lorenalam/TFG/Documentation/SPECS_TFG_PCB_LORENALAM.docx

TRABAJO DE FIN DE GRADO

“ Desarrollo de una PCB Gateway para la gestión de señales en un prototipo ‘Formula Student’ ”

1.DISEÑO PCB

1.1 Medidas que queremos tomar:

-ACELERADOR -analógica

APPS_1

APPS_2

Tasa muestreo – 10 ms (100Hz)

ELPM 75 POP- linear potentiometer- YA COMPRADO

https://www.digikey.es/es/products/detail/variohm/ELPM-75-POP/22286964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

-POTENCIÓMETROS SUSPENSIÓN -analógica

SUSP_FL

SUSP_FR

Tasa muestreo – 10ms/5ms (100Hz-200Hz)

ELPM 75 POP- linear potentiometer -YA COMPRADO

https://www.digikey.es/es/products/detail/variohm/ELPM-75-POP/22286964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

-SENSOR DE PRESIÓN FRENOS- analógica

EPT1400 Pressure Sensor- YA COMPRADO

https://www.variohm.com/products/pressure-sensors/pressure-sensors/ept1400

-SENSOR TEMPERATURA DE DISCO DE FRENO-analógica/digital(SPI)

TEMPS_BRK

Tasa muestreo- (4Hz)

MÓDULO MAX6675

-Tiempo de conversión del módulo ~ 220-250ms

https://www.analog.com/media/en/technical-documentation/data-sheets/max6675.pdf

+TERMOPAR

https://it.farnell.com/pico-technology/se001/type-k-thermocouple-probe-exposed/dp/2842094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|pcrid||&gad_source=1&gad_campaignid=18436055022&gbraid=0AAAAAD8yeHlS3ae2XJ_zIs-uri2sHP3N5&gclid=CjwKCAiAw9vIBhBBEiwAraSATnFp6UBgSgxSIfs22Lk9t7jn8zENQ2MidookhQyCFX7BkOckKrozjxoC0bMQAvD_BwE

-SENSOR TEMPERATURA RUEDAS TESTING x2- digital (I2C)

TEMP_TYRE_1

TEMP_TYRE_2

Tasa muestreo – a partir de 100 ms (10 Hz)

MLX90614

-Tasa de refresco sensor~ 10Hz

https://cdn-reichelt.de/documents/datenblatt/A300/SEN-IR-TEMP_DATASHEET_2022-07-15.pdf

-SENSOR PRESIÓN CARGA AERODINÁMICA- analógica/digital (I2C/SPI)

(pendiente de confirmar por presupuesto)

1.2 Opciones de Microcontroladores:

-Características imprescindibles:

1.CANH FD (Flexible Data-Rate) –> -velocidad del bus hasta 8Mbits/s

-64 bytes por trama

2.Lectura de 5 medidas analóg (al menos 5 canales ADC multiplexados)

3.Comunicación I2C

4.Comunicación SPI

5. Procesamiento de datos a frecuencias medias (10-200Hz)

FAMILIAS DE STM32

STM32F-> NO OK- no soporta CAN FD

STM32G-> OK (gama más nueva)

STM32H->OK (gama más potente)

Resumen de las familias (https://www.google.com/url?psig=AOvVaw0HygEP8Ei9MHWAovS-F1P9&cd=vfe&opi=89978449)

Posibles candidatos:

-STM32H733ZGTx:

Es el actualmente usado en la MCU (Main Control Unit) del prototipo:

Cuenta con estas características:

- Cortex-M7 @ 550 MHz

- 1 MB Flash + 564 KB RAM

- ADCs 16 bits (~3.6 MSps)

- 2× CAN FD

- 6× SPI, 6× I²C, 8× UART

- Ethernet, USB, SDMMC, TFT/LCD, DMA2D

Esta MUY sobredimensionado para las funciones que queremos llevar a cabo en nuestra placa.

-STM32H5xxxx SERIES:

Características generales:

- CPU: ARM Cortex-M33
- Frecuencia CPU típica: ~250 MHz
- Flash: 256 KB – 2 MB
- RAM: 136 KB – 640 KB según modelo
- ADC rápido (14 bits)
- CAN FD
- I²C, SPI, USART

-STM32H503: gama básica (Low-Cost H5)-> NO OK, no integra CAN

-STM32H533 / H535 :gama media (Mainstream H5)-> un poco flojo en cuanto a RAM y Flash

-STM32H563x — High Integration gama industrial-> Sobredimensionado

-STM32H523 / H533 / H563 : gama media-alta (High Integration)-> OK

STM32H523xxx:

- Flash: 512 KB – 2 MB
- RAM: 320–640 KB
- 1 o 2 CAN FD (según el modelo exacto)
- Múltiples SPI (3–6) e I²C (2–4)
- ADC potente (suficientes canales)

-posible: STM32H523CET6

https://static6.arrow.com/aropdfconversion/778a60b664bf8f25dd257b3928806fe0144b5d5/stm32h523ce.pdf

2.ESTADO DE LA TÉCNICA

Denificiones y especificaciones de la 1era version del protocolo CAN:

Specification, C. A. N. (1991). Bosch. Robert Bosch GmbH, Postfach, 50, 15. (https://old.autonerdz.com/yabbfiles/Attachments/can2spec.pdf)

https://www.csselectronics.com/pages/can-bus-simple-intro-tutorial

Denificiones y especificaciones del protocolo CANFD:

Hartwich, F. (2012, March). CAN with flexible data-rate. In Proc. iCC (pp. 1-9). Citeseer. (http://s3.eu-central-1.amazonaws.com/cancia-de/documents/proceedings/2012_hartwich.pdf)

Uso del protocolo y bus CAN para automoción con núcleos RaspberryPi:

Salunkhe, A. A., Kamble, P. P., & Jadhav, R. (2016, May). Design and implementation of CAN bus protocol for monitoring vehicle parameters. In 2016 IEEE international conference on recent trends in electronics, information & communication technology (RTEICT) (pp. 301-304). IEEE (https://ieeexplore.ieee.org/stamp/stamp.jsp?tp=&arnumber=7807831)

IMPLEMENTACIÓN/PRUEBAS EN NUCLEO STM32

NUCLEO-H533RE

PROS:

-Pertenece a la misma familia STM32H5 que el micro final (firmware)

- Incluye FDCAN → permite probar comunicación CAN FD real antes del diseño PCB. - Tiene ADC, SPI, I²C eaccesibles → para validar todos los sensores.

- Trae ST-LINK integrado → programación y depuración inmediatas sin hardware extra

CONTRAS:

- Usa un encapsulado LQFP64: pinout NO compatible con el STM32H523CET6 de la PCB final.

-Tiene más pines y periféricos

-Hay que adaptar el mapeo de pines al pasar al micro definitivo (LQFP48).

-El layout de señales críticas (CAN, ADC, sensores) no representa la PCB real.

-PEDIDO A STMicroelectronics

Otras opcs:

NUCLEO-H503-> ideal pero NO soporta CANFD

STM32CUBE IDE GETTING STARTED:

Intro to núcleo Boards:

Introduction To STM32 & Nucleo Boards - YouTube (https://www.youtube.com/watch?v=mSMsrP31QqA)

Tutorial de STM32: Consejos y trucos para principiantes de STM32CubeIDE

https://www.youtube.com/watch?v=QOHMskuDc78

Getting started w/ NUCLEO-H5:

https://www.youtube.com/watch?v=R6g0OqE_wSo

APUNTES/CONSIDERACIONES

ARCHIVO ioc:

Aquí configuras:

- Los pines (pinout)
- Los periféricos (CAN, ADC, UART, timers…)
- Los relojes (Clock Configuration)
- El middleware ( USB, etc.)

Y el ide ya solo te configura los drivers con los regristors, configs etc pertinentes NO hace falta hacerlo a mano!

- Te genera el código HAL solo

NOTA:

Que es HAL? Hardware Abstraction Layer (Es como una “capa” que simplifica el acceso al hardware.)

Biblioteca oficial de STMicroelectronics, escrita en C, que te permite usar los periféricos del micro (CAN, ADC, UART, timers, GPIO…) con funciones sencillas, sin tener que programar los registros internos del microcontrolador uno a uno.

Nos proporciona un montón de funciones listas para trabajar con:

LAS MÁS TIPICAS:

GPIO (entradas/salidas, LEDs, interrupciones)

Escritura / lectura:

HAL_GPIO_WritePin(GPIOx, GPIO_PIN_y, GPIO_PIN_SET);

HAL_GPIO_WritePin(GPIOx, GPIO_PIN_y, GPIO_PIN_RESET);

HAL_GPIO_TogglePin(GPIOx, GPIO_PIN_y);

HAL_GPIO_ReadPin(GPIOx, GPIO_PIN_y);

ADC (lectura de sensores analógicos)

HAL_ADC_Start(&hadcX);

HAL_ADC_PollForConversion(&hadcX, 10);

value = HAL_ADC_GetValue(&hadcX);

HAL_ADC_Stop(&hadcX);

FDCAN

Iniciar CAN:

HAL_FDCAN_Start(&hfdcan1);

Configurar filtros:

HAL_FDCAN_ConfigFilter(&hfdcan1, &filter);

Enviar mensajes:

HAL_FDCAN_AddMessageToTxFifoQ(&hfdcan1, &TxHeader, TxData);

Activar interrupciones:

HAL_FDCAN_ActivateNotification(&hfdcan1, FDCAN_IT_RX_FIFO0_NEW_MESSAGE, 0);

Recibir mensajes (en callback):

HAL_FDCAN_GetRxMessage(&hfdcan1, FDCAN_RX_FIFO0, &RxHeader, RxData);

CÓMO CONFIGURAR DE MANERA BÁSICA CANFD EN STM32CUBEIDE:

FRAME CAN FD:

1. ID (identificador)

- Igual que en CAN clásico
- Normalmente 11 bits (standard ID)/ También puede ser de 29 bits (extended)

2. DLC (Data Length Code)

- Indica cuántos bytes de datos lleva

3. Datos (payload)

- 0 a 64 bytes, frente a 8 bytes en CAN clásico

4. CRC

- Cyclic Redundancy check (para los errores)

5. Flags específicos de CAN-FD

Los dos más importantes:

- FDF → indica que es un frame CAN-FD
- BRS (Bit Rate Switch) → indica si los datos se envían a mayor velocidad

6. Otros bits y campos

- Ej: Bits de estado

CON EL IDE SOLO TOCAMOS:

-ID
-DLC
-Data[] (hasta 64 bytes)
-FDFormat indica si es can normal o fd
- BitRateSwitch indica si el frame entero va a la misma velocidad o si la parte de datos va mas rápido que la cabecera

El resto (CRC, flags internos, secuencia del frame) lo hace el periférico automáticamente.

ANEXO-SUCIO

-CONFIGURACIÓN DEL BUS CAN EN EL MICRO

-AUTOMOTIVE IC BOARDS STM32 investigar en la pagina web de STM

-STM32cubeID -> investigar el IDE

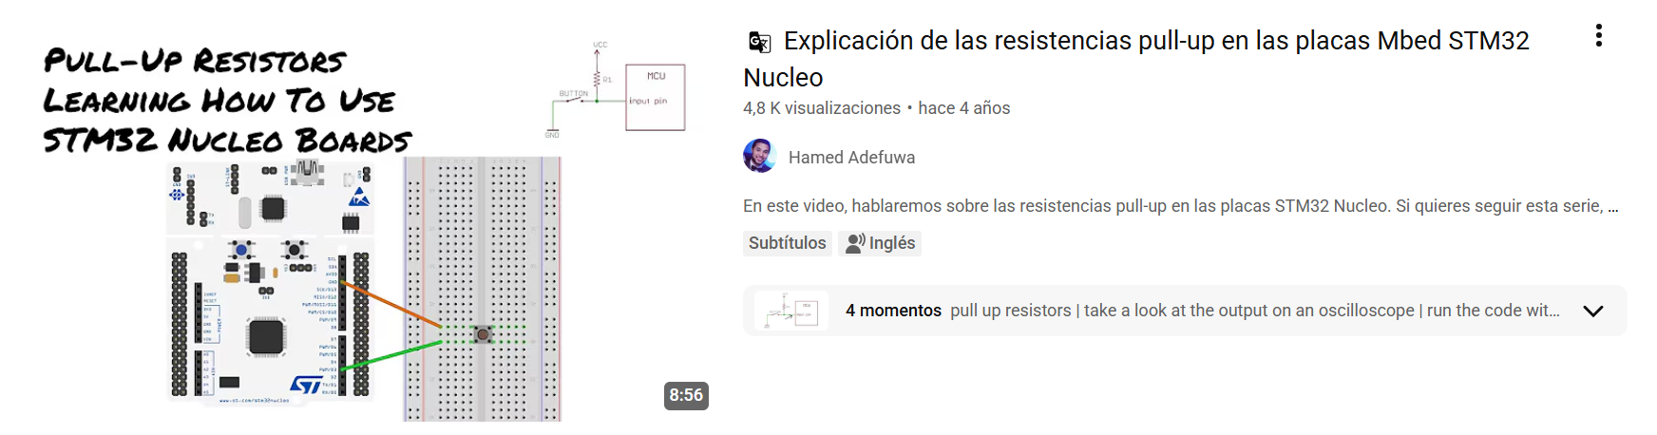
[picture p1: figure]
