lorenalam/TFG/Hardware/PCB_TFG_v1.3/PCB_TFG_v1.3.kicad_pcb

## KiCad design Hardware/PCB_TFG_v1.3/PCB_TFG_v1.3.kicad_pcb (2026-05-29)

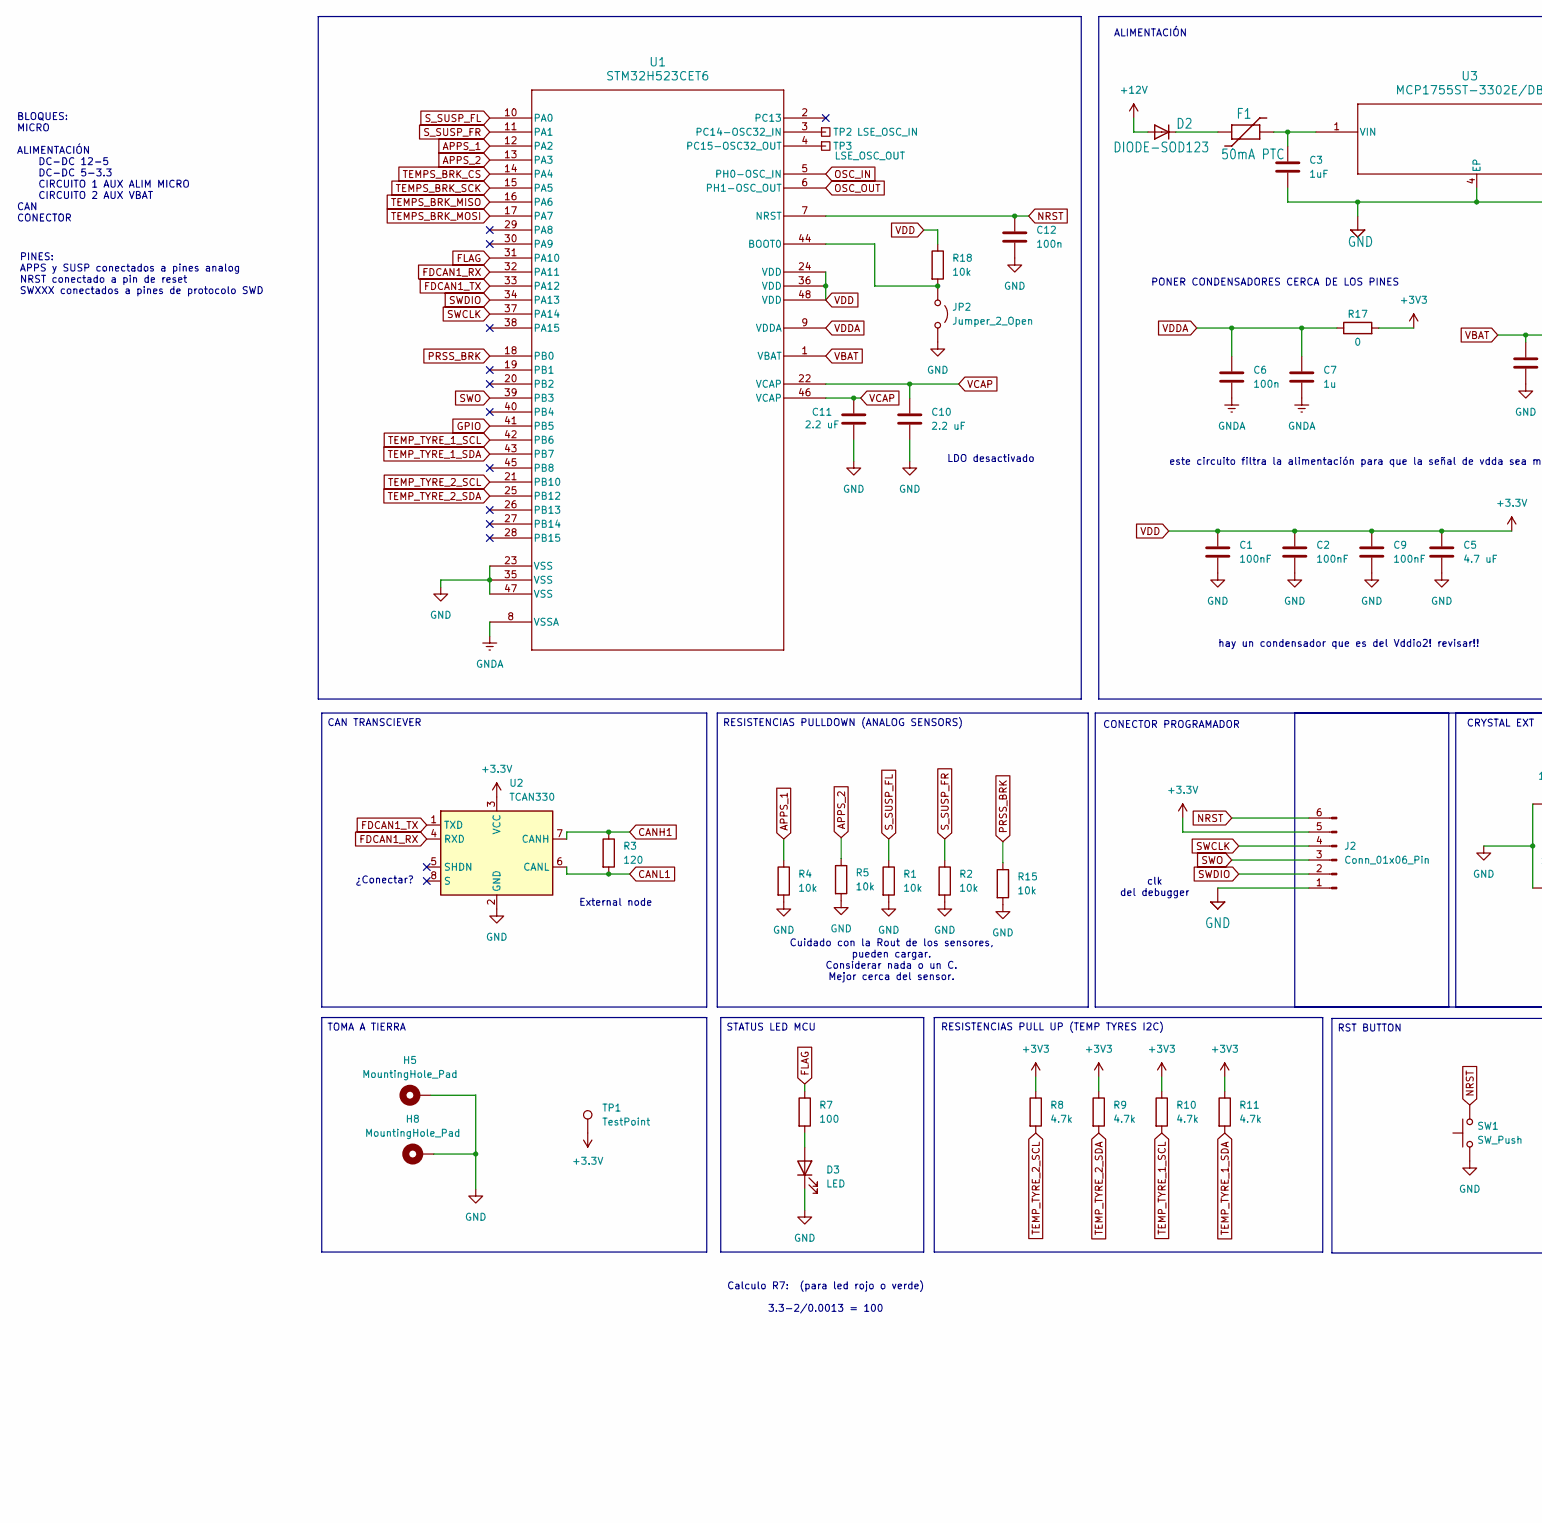
[picture p2: schematic PCB_TFG_v1.3.kicad_sch, part in row 1, column 1]

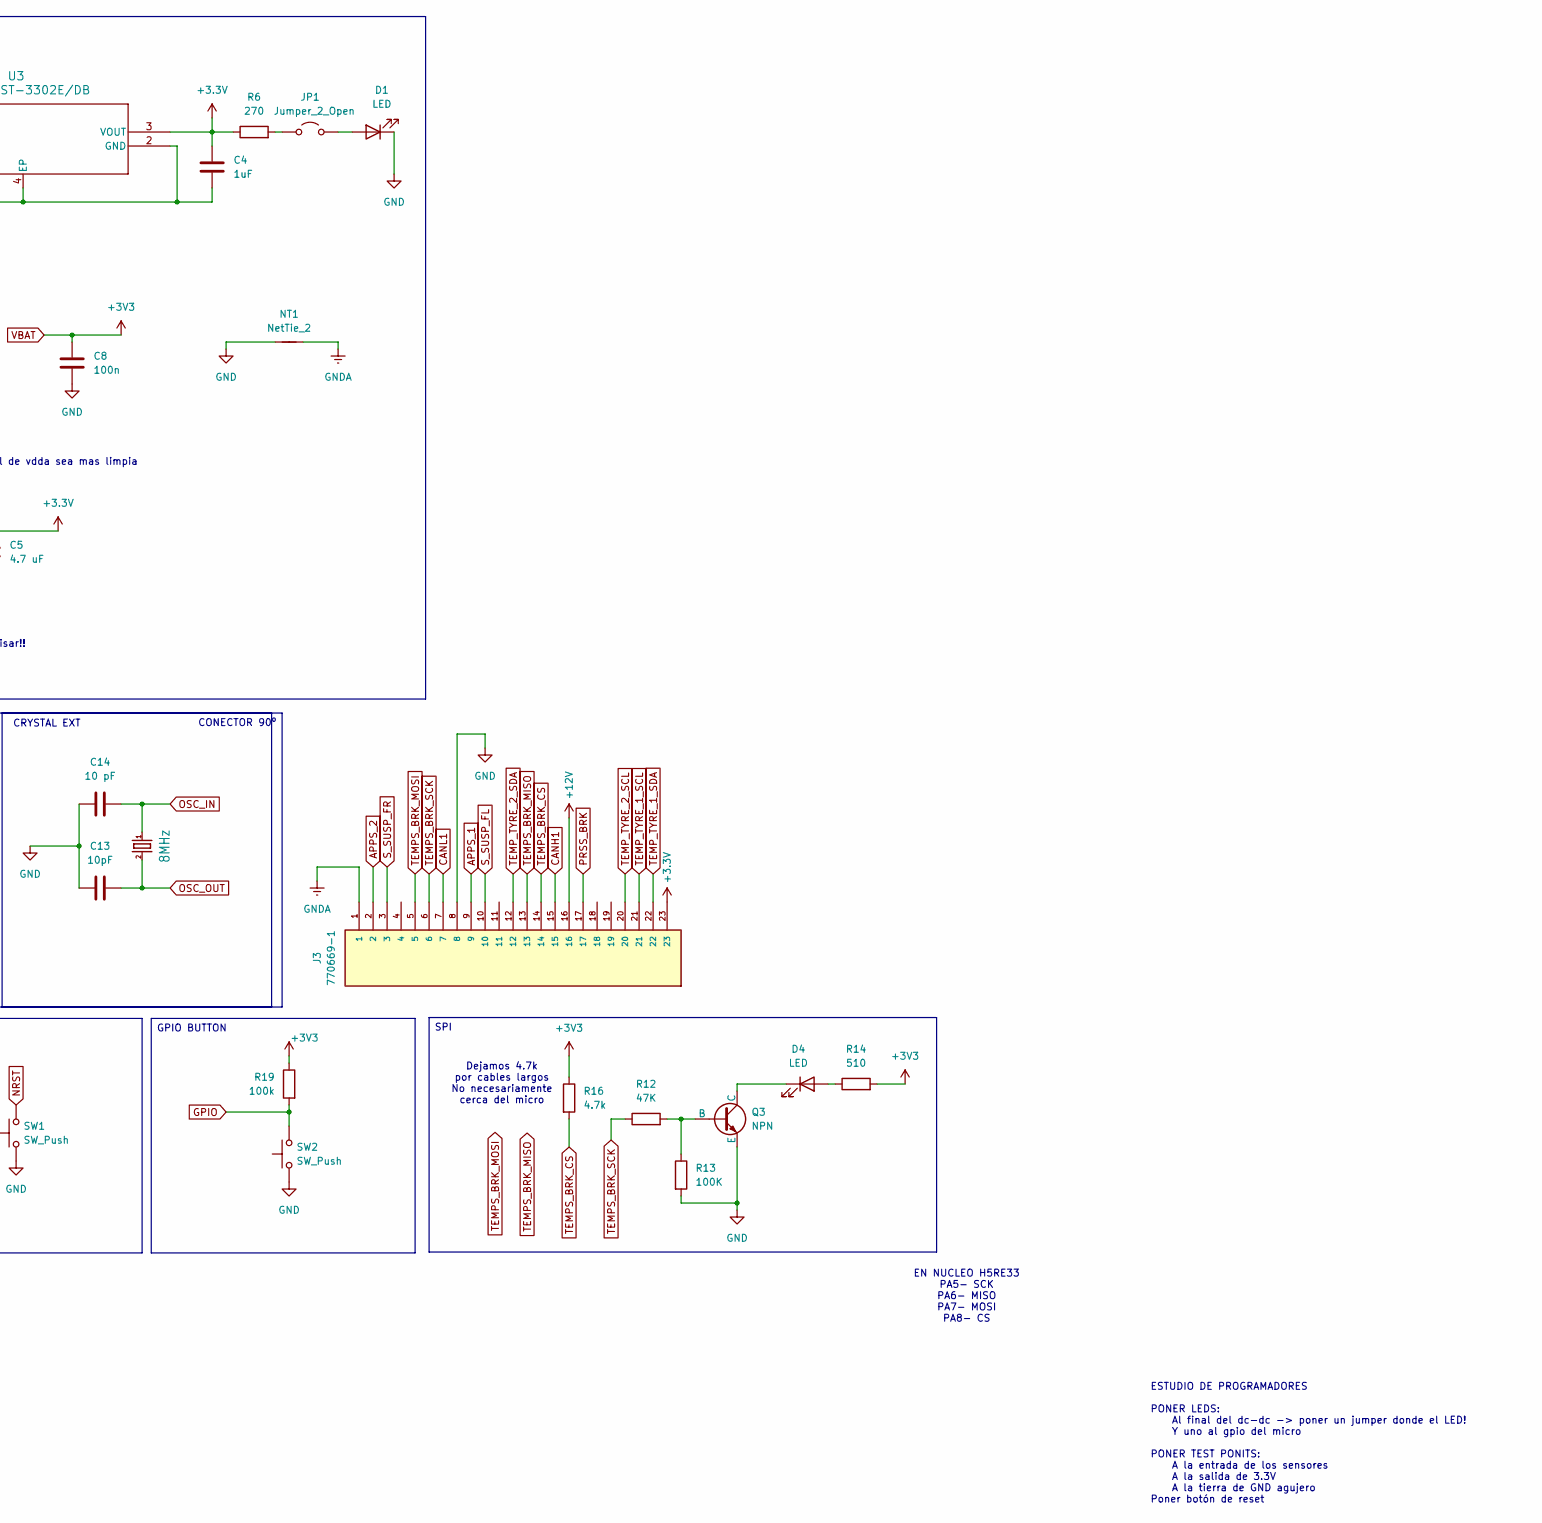
[picture p3: schematic PCB_TFG_v1.3.kicad_sch, part in row 1, column 2]

Parts:
C1, C2, C9: 100nF; C_0805_2012Metric_Pad1.18x1.45mm_HandSolder
C3, C4: 1uF; C_0805_2012Metric_Pad1.18x1.45mm_HandSolder
C5: 4.7 uF; C_0805_2012Metric_Pad1.18x1.45mm_HandSolder
C6, C8, C12: 100n; C_0805_2012Metric_Pad1.18x1.45mm_HandSolder
C7: 1u; C_0805_2012Metric_Pad1.18x1.45mm_HandSolder
C10, C11: 2.2 uF; C_0805_2012Metric_Pad1.18x1.45mm_HandSolder
C13: 10pF; C_0805_2012Metric_Pad1.18x1.45mm_HandSolder
C14: 10 pF; C_0805_2012Metric_Pad1.18x1.45mm_HandSolder
D1, D3, D4: LED; LED_0805_2012Metric_Pad1.15x1.40mm_HandSolder
D2: DIODE-SOD123; SOD123
F1: 50mA PTC; 1206
H5, H8: MountingHole_Pad; MountingHole_3.2mm_M3_ISO14580_Pad_TopBottom
J2: Conn_01x06_Pin; PinHeader_2x03_P2.54mm_Vertical
J3: 770669-1; TE_770669-1; PARTREV K11
JP1: Jumper_2_Open; SolderJumper-2_P1.3mm_Open_RoundedPad1.0x1.5mm
JP2: Jumper_2_Open; PinHeader_1x02_P2.54mm_Vertical
NT1: NetTie_2; NetTie-2_SMD_Pad0.5mm
Q1: 8MHz; CTS406
Q3: NPN; TSOT-23
R1, R2, R4, R5, R15, R18: 10k; R_0805_2012Metric_Pad1.20x1.40mm_HandSolder
R3: 120; R_0805_2012Metric_Pad1.20x1.40mm_HandSolder
R6: 270; R_0805_2012Metric_Pad1.20x1.40mm_HandSolder
R7: 100; R_0805_2012Metric_Pad1.20x1.40mm_HandSolder
R8, R9, R10, R11, R16: 4.7k; R_0805_2012Metric_Pad1.20x1.40mm_HandSolder
R12: 47K; R_0805_2012Metric_Pad1.20x1.40mm_HandSolder
R13: 100K; R_0805_2012Metric_Pad1.20x1.40mm_HandSolder
R14: 510; R_0805_2012Metric_Pad1.20x1.40mm_HandSolder
R17: 0; R_0805_2012Metric_Pad1.20x1.40mm_HandSolder
R19: 100k; R_0805_2012Metric_Pad1.20x1.40mm_HandSolder
SW1, SW2: SW_Push; SW_SPST_B3U-1000P-B
TP1: TestPoint; Pin_D1.0mm_L10.0mm
TP2: LSE_OSC_IN; TestPoint_Pad_1.0x1.0mm
TP3: LSE_OSC_OUT; TestPoint_Pad_1.0x1.0mm
U1: STM32H523CET6; LQFP48_STM
U2: TCAN330; SOIC-8_3.9x4.9mm_P1.27mm
U3: MCP1755ST-3302E/DB; SOT-223_3MC_MCH

Connections:
+12V: D2.A, J3.16
APPS_1: J3.9, R4.1, U1.12 (PA2)
APPS_2: J3.2, R5.1, U1.13 (PA3)
CANH1: J3.15, R3.1, U2.7 (CANH)
CANL1: J3.7, R3.2, U2.6 (CANL)
FDCAN1_RX: U1.32 (PA11), U2.4 (RXD)
FDCAN1_TX: U1.33 (PA12), U2.1 (TXD)
FLAG: R7.1, U1.31 (PA10)
GND: C1.2, C2.2, C3.2, C4.2, C5.2, C8.1, C9.2, C10.2, C11.2, C12.1, C13.1, C14.1, D1.1 (K), D3.1 (K), H5.1 (1_1), H8.1 (1_1), J2.1, J3.8, JP2.2 (B), NT1.1, Q3.3 (E), R1.2, R2.2, R4.2, R5.2, R13.2, R15.2, SW1.1, SW2.1, U1.23 (VSS), U1.35 (VSS), U1.47 (VSS), U2.2 (GND), U3.2 (GND), U3.4 (EP)
GNDA: C6.1, C7.1, J3.1, NT1.2, U1.8 (VSSA)
GPIO: R19.2, SW2.2, U1.41 (PB5)
NRST: C12.2, J2.6, SW1.2, U1.7 (NRST)
unnamed: D1.2 (A), JP1.2 (B)
unnamed: D2.C, F1.P$1
unnamed: D3.2 (A), R7.2
unnamed: D4.2 (A), R14.1
unnamed: D4.1 (K), Q3.1 (C)
unnamed: JP1.1 (A), R6.2
unnamed: JP2.1 (A), R18.2, U1.44 (BOOT0)
unnamed: Q3.2 (B), R12.2, R13.1
unnamed: TP2.1 (1_1), U1.3 (PC14-OSC32_IN)
unnamed: TP3.1 (1_1), U1.4 (PC15-OSC32_OUT)
unnamed: C3.1, F1.P$2, U3.1 (VIN)
OSC_IN: C14.2, Q1.1, U1.5 (PH0-OSC_IN)
OSC_OUT: C13.2, Q1.3 (2), U1.6 (PH1-OSC_OUT)
PRSS_BRK: J3.17, R15.1, U1.18 (PB0)
SWCLK: J2.4, U1.37 (PA14)
SWDIO: J2.2, U1.34 (PA13)
SWO: J2.3, U1.39 (PB3)
S_SUSP_FL: J3.10, R1.1, U1.10 (PA0)
S_SUSP_FR: J3.3, R2.1, U1.11 (PA1)
TEMPS_BRK_CS: J3.14, R16.2, U1.14 (PA4)
TEMPS_BRK_MISO: J3.13, U1.16 (PA6)
TEMPS_BRK_MOSI: J3.5, U1.17 (PA7)
TEMPS_BRK_SCK: J3.6, R12.1, U1.15 (PA5)
TEMP_TYRE_1_SCL: J3.21, R10.2, U1.42 (PB6)
TEMP_TYRE_1_SDA: J3.22, R11.2, U1.43 (PB7)
TEMP_TYRE_2_SCL: J3.20, R8.2, U1.21 (PB10)
TEMP_TYRE_2_SDA: J3.12, R9.2, U1.25 (PB12)
VBAT: C8.2, R8.1, R9.1, R10.1, R11.1, R14.2, R16.1, R17.2, R19.1, U1.1 (VBAT)
VCAP: C10.1, C11.1, U1.22 (VCAP), U1.46 (VCAP)
VDD: C1.1, C2.1, C4.1, C5.1, C9.1, J2.5, J3.23, R6.1, R18.1, TP1.1 (1_1), U1.24 (VDD), U1.36 (VDD), U1.48 (VDD), U2.3 (VCC), U3.3 (VOUT)
VDDA: C6.2, C7.2, R17.1, U1.9 (VDDA)

Notes on the sheet:
PONER CONDENSADORES CERCA DE LOS PINES
ESTUDIO DE PROGRAMADORES PONER LEDS: Al final del dc-dc -> poner un jumper donde el LED! Y uno al gpio del micro PONER TEST PONITS: A la entrada de los sensores A la salida de 3.3V A la tierra de GND agujero Poner botón de reset
EN NUCLEO H5RE33 PA5- SCK PA6- MISO PA7- MOSI PA8- CS
BLOQUES: MICRO ALIMENTACIÓN DC-DC 12-5 DC-DC 5-3.3 CIRCUITO 1 AUX ALIM MICRO CIRCUITO 2 AUX VBAT CAN CONECTOR
CONECTOR PROGRAMADOR
clk del debugger
Cuidado con la Rout de los sensores, pueden cargar. Considerar nada o un C. Mejor cerca del sensor.
RESISTENCIAS PULL UP (TEMP TYRES I2C)
Calculo R7: (para led rojo o verde) 3.3-2/0.0013 = 100
Dejamos 4.7k por cables largos No necesariamente cerca del micro
External node
LDO desactivado
este circuito filtra la alimentación para que la señal de vdda sea mas limpia
¿Conectar?
PINES: APPS y SUSP conectados a pines analog NRST conectado a pin de reset SWXXX conectados a pines de protocolo SWD
hay un condensador que es del Vddio2! revisar!!
ALIMENTACIÓN
CRYSTAL EXT
TOMA A TIERRA
RESISTENCIAS PULLDOWN (ANALOG SENSORS)
GPIO BUTTON
CONECTOR 90º
SPI
CAN TRANSCIEVER
STATUS LED MCU
RST BUTTON

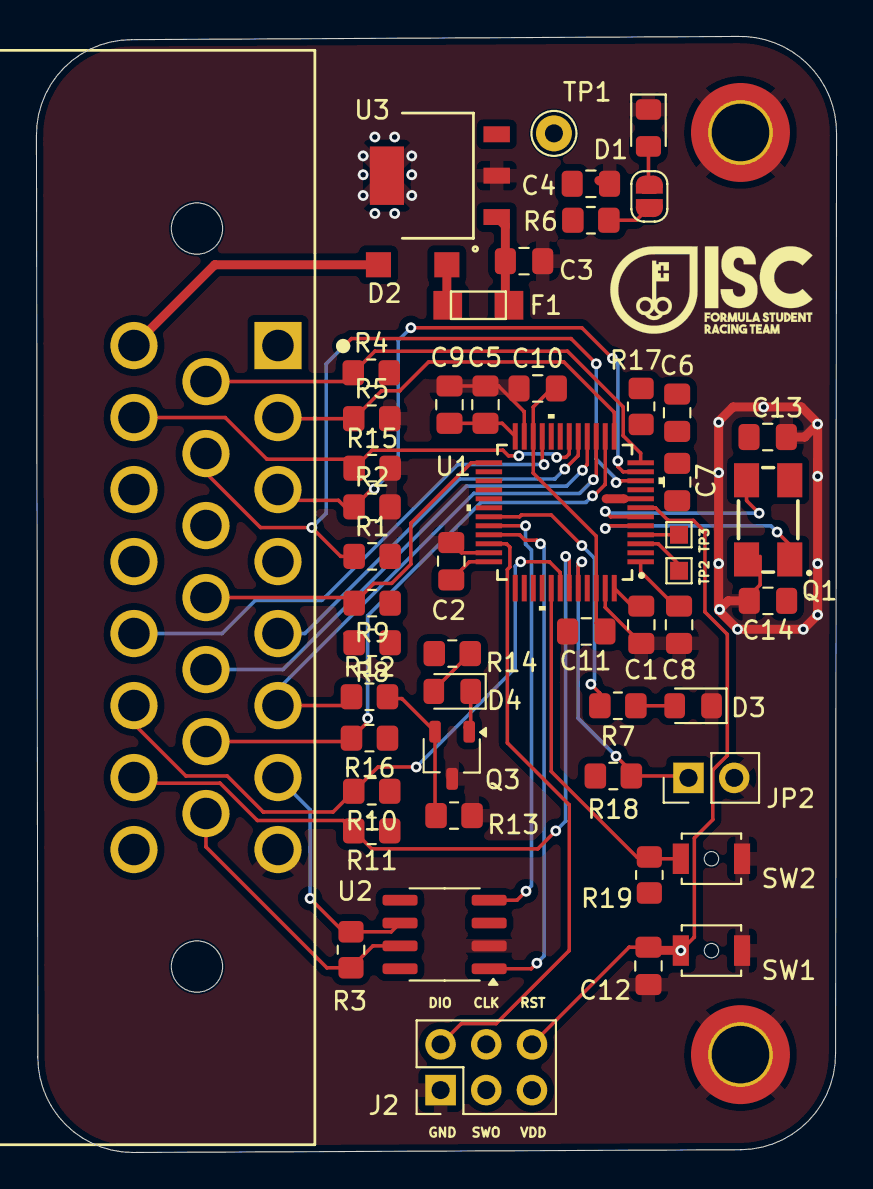
[picture p4: board PCB_TFG_v1.3.kicad_pcb from above]

Board: 4 copper layers, 44.4 x 62.0 mm, 55 parts (0 on the bottom side), 43 nets.
