lorenalam/TFG/Hardware/PCB_TFG_v1.2/PCB_TFG_v1.2.kicad_pcb

## KiCad design Hardware/PCB_TFG_v1.2/PCB_TFG_v1.2.kicad_pcb (2026-05-07, an earlier design)

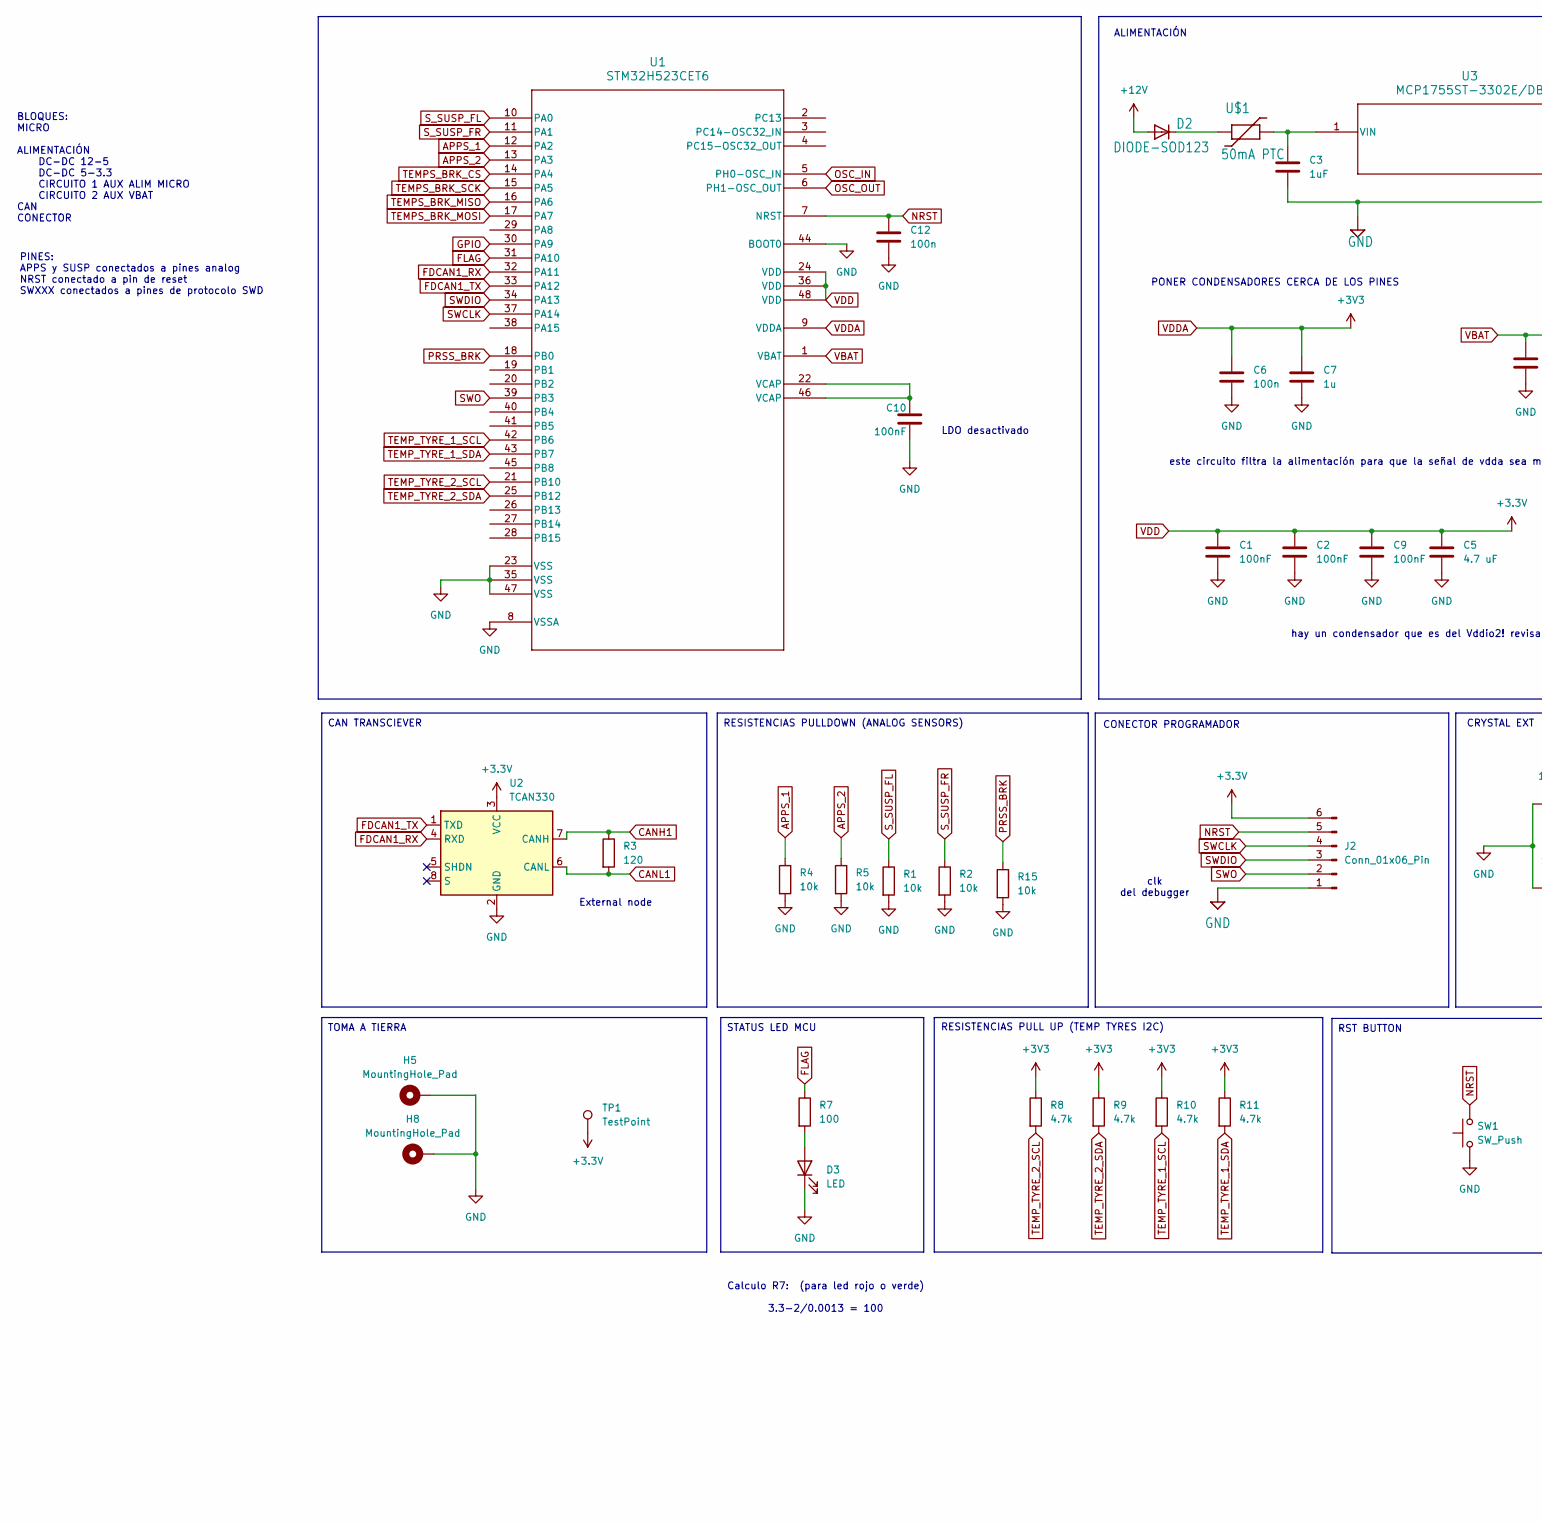
[picture p5: schematic PCB_TFG_v1.2.kicad_sch, part in row 1, column 1]

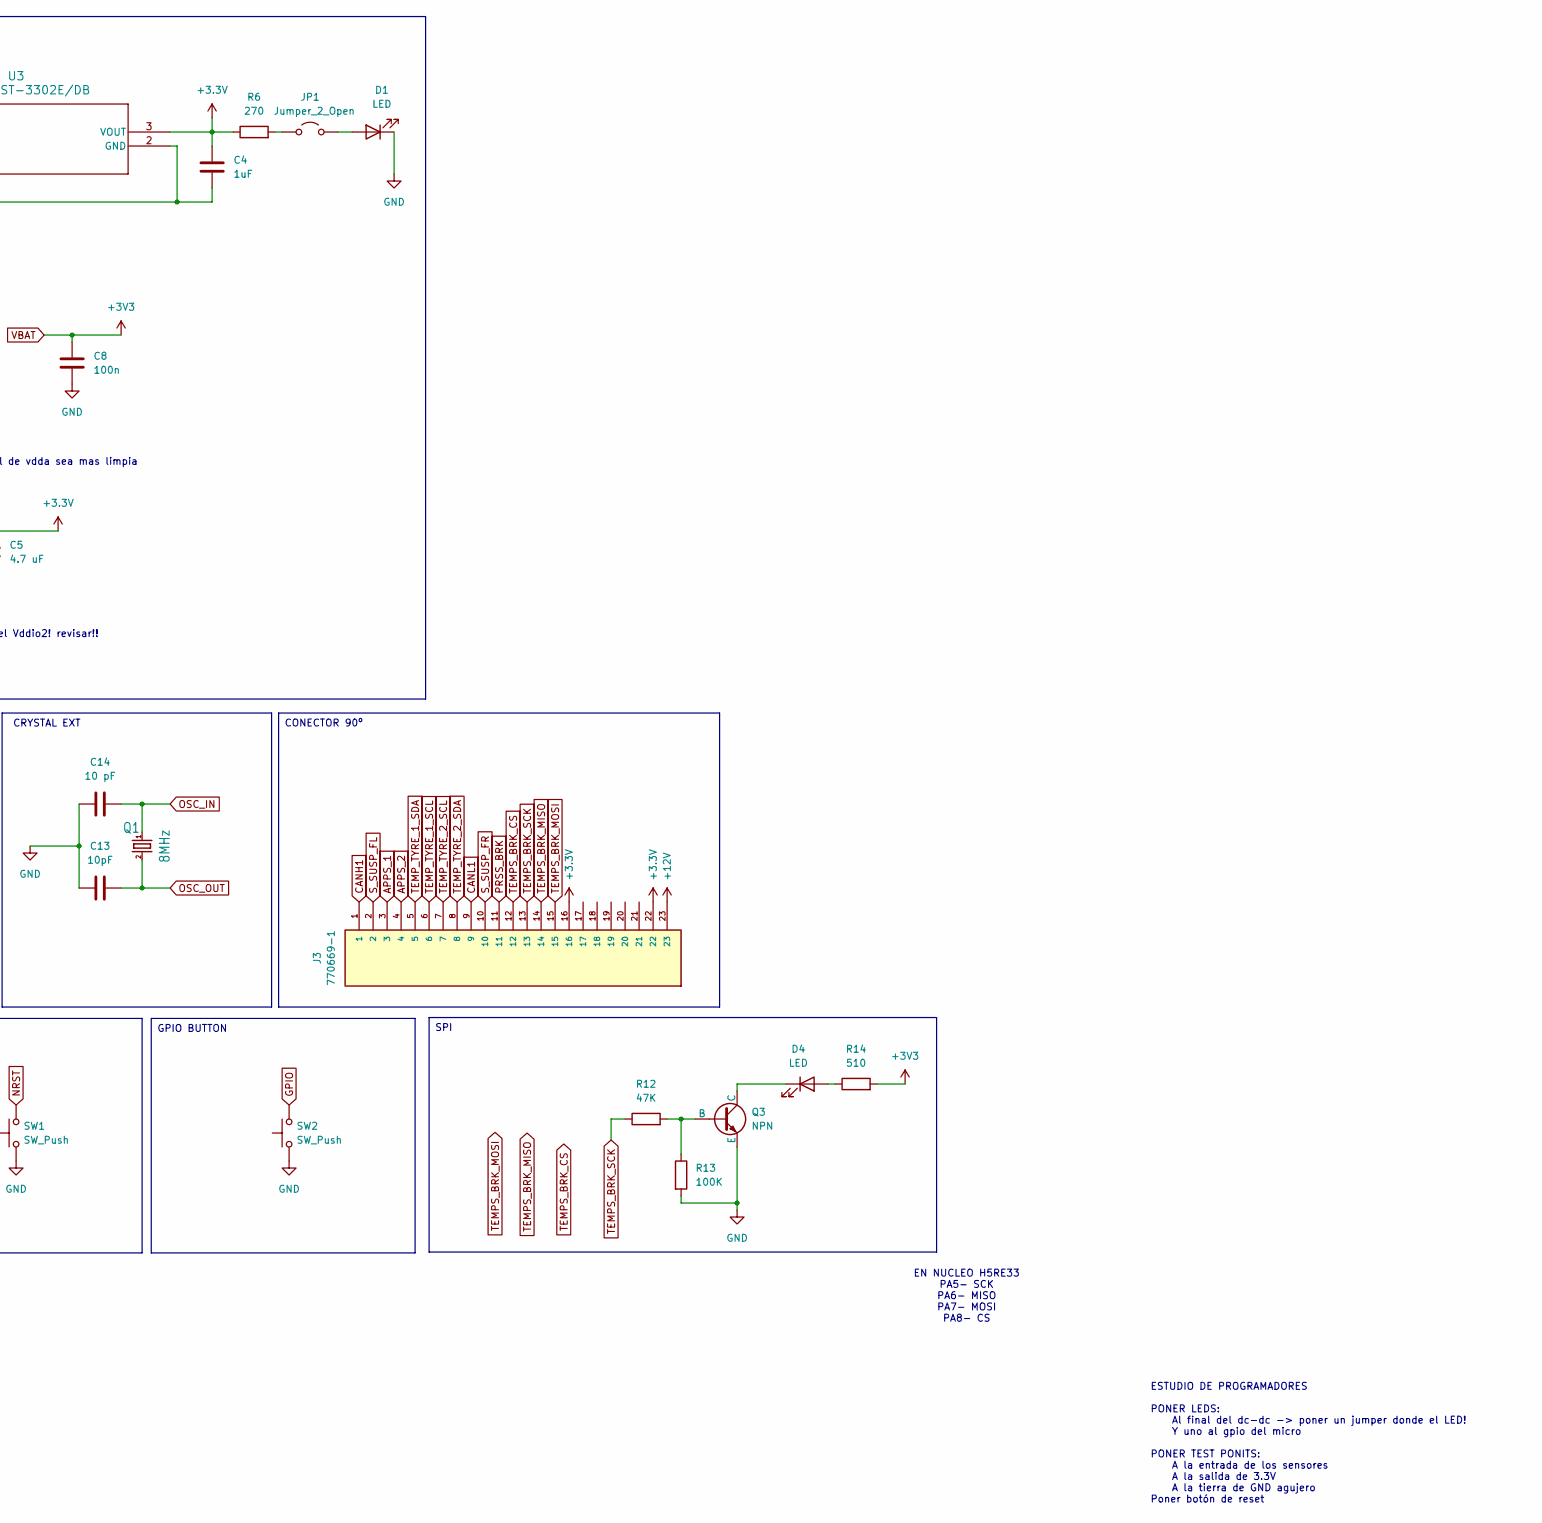
[picture p6: schematic PCB_TFG_v1.2.kicad_sch, part in row 1, column 2]

Parts:
C1, C2, C9, C10: 100nF; C_0805_2012Metric_Pad1.18x1.45mm_HandSolder
C3, C4: 1uF; C_0805_2012Metric_Pad1.18x1.45mm_HandSolder
C5: 4.7 uF; C_0805_2012Metric_Pad1.18x1.45mm_HandSolder
C6, C8: 100n; C_0805_2012Metric_Pad1.18x1.45mm_HandSolder
C7: 1u; C_0805_2012Metric_Pad1.18x1.45mm_HandSolder
C12: 100n; C_0603_1608Metric_Pad1.08x0.95mm_HandSolder
C13: 10pF; C_0805_2012Metric_Pad1.18x1.45mm_HandSolder
C14: 10 pF; C_0805_2012Metric_Pad1.18x1.45mm_HandSolder
D1, D3, D4: LED; LED_0805_2012Metric_Pad1.15x1.40mm_HandSolder
D2: DIODE-SOD123; SOD123
H5, H8: MountingHole_Pad; MountingHole_3.2mm_M3_ISO14580_Pad_TopBottom
J2: Conn_01x06_Pin; PinHeader_2x03_P2.54mm_Vertical
J3: 770669-1; TE_770669-1; PARTREV K11
JP1: Jumper_2_Open; SolderJumper-2_P1.3mm_Open_RoundedPad1.0x1.5mm
Q1: 8MHz; CTS406
Q3: NPN; TSOT-23
R1, R2, R4, R5, R15: 10k; R_0805_2012Metric_Pad1.20x1.40mm_HandSolder
R3: 120; R_0805_2012Metric_Pad1.20x1.40mm_HandSolder
R6: 270; R_0805_2012Metric_Pad1.20x1.40mm_HandSolder
R7: 100; R_0805_2012Metric_Pad1.20x1.40mm_HandSolder
R8, R9, R10, R11: 4.7k; R_0805_2012Metric_Pad1.20x1.40mm_HandSolder
R12: 47K; R_0805_2012Metric_Pad1.20x1.40mm_HandSolder
R13: 100K; R_0805_2012Metric_Pad1.20x1.40mm_HandSolder
R14: 510; R_0805_2012Metric_Pad1.20x1.40mm_HandSolder
SW1, SW2: SW_Push; SW_PUSH_6mm_H4.3mm
TP1: TestPoint; Pin_D1.0mm_L10.0mm
U1: STM32H523CET6; LQFP48_STM
U2: TCAN330; SOIC-8_3.9x4.9mm_P1.27mm
U3: MCP1755ST-3302E/DB; SOT-223_3MC_MCH
U$1: 50mA PTC; 1206

Connections:
+12V: D2.A, J3.23
APPS_1: J3.3, R4.1, U1.12 (PA2)
APPS_2: J3.4, R5.1, U1.13 (PA3)
CANH1: J3.1, R3.1, U2.7 (CANH)
CANL1: J3.9, R3.2, U2.6 (CANL)
FDCAN1_RX: U1.32 (PA11), U2.4 (RXD)
FDCAN1_TX: U1.33 (PA12), U2.1 (TXD)
FLAG: R7.1, U1.31 (PA10)
GND: C1.2, C2.2, C3.2, C4.2, C5.2, C6.1, C7.1, C8.1, C9.2, C10.2, C12.1, C13.1, C14.1, D1.1 (K), D3.1 (K), H5.1, H8.1, J2.1, Q3.3 (E), R1.2, R2.2, R4.2, R5.2, R13.2, R15.2, SW1.1, SW2.1, U1.8 (VSSA), U1.23 (VSS), U1.35 (VSS), U1.44 (BOOT0), U1.47 (VSS), U2.2 (GND), U3.2 (GND)
GPIO: SW2.2, U1.30 (PA9)
NRST: C12.2, J2.5, SW1.2, U1.7 (NRST)
unnamed: C10.1, U1.22 (VCAP), U1.46 (VCAP)
unnamed: D1.2 (A), JP1.2 (B)
unnamed: D2.C, U$1.P$1
unnamed: D3.2 (A), R7.2
unnamed: D4.2 (A), R14.1
unnamed: D4.1 (K), Q3.1 (C)
unnamed: JP1.1 (A), R6.2
unnamed: Q3.2 (B), R12.2, R13.1
unnamed: C3.1, U3.1 (VIN), U$1.P$2
OSC_IN: C14.2, Q1.1, U1.5 (PH0-OSC_IN)
OSC_OUT: C13.2, Q1.3 (2), U1.6 (PH1-OSC_OUT)
PRSS_BRK: J3.11, R15.1, U1.18 (PB0)
SWCLK: J2.4, U1.37 (PA14)
SWDIO: J2.3, U1.34 (PA13)
SWO: J2.2, U1.39 (PB3)
S_SUSP_FL: J3.2, R1.1, U1.10 (PA0)
S_SUSP_FR: J3.10, R2.1, U1.11 (PA1)
TEMPS_BRK_CS: J3.12, U1.14 (PA4)
TEMPS_BRK_MISO: J3.14, U1.16 (PA6)
TEMPS_BRK_MOSI: J3.15, U1.17 (PA7)
TEMPS_BRK_SCK: J3.13, R12.1, U1.15 (PA5)
TEMP_TYRE_1_SCL: J3.6, R10.2, U1.42 (PB6)
TEMP_TYRE_1_SDA: J3.5, R11.2, U1.43 (PB7)
TEMP_TYRE_2_SCL: J3.7, R8.2, U1.21 (PB10)
TEMP_TYRE_2_SDA: J3.8, R9.2, U1.25 (PB12)
VBAT: C6.2, C7.2, C8.2, R8.1, R9.1, R10.1, R11.1, R14.2, U1.1 (VBAT), U1.9 (VDDA)
VDD: C1.1, C2.1, C4.1, C5.1, C9.1, J2.6, J3.16, J3.22, R6.1, TP1.1, U1.24 (VDD), U1.36 (VDD), U1.48 (VDD), U2.3 (VCC), U3.3 (VOUT)

Notes on the sheet:
TOMA A TIERRA
RESISTENCIAS PULLDOWN (ANALOG SENSORS)
GPIO BUTTON
CONECTOR 90º
SPI
CAN TRANSCIEVER
STATUS LED MCU
RST BUTTON
PONER CONDENSADORES CERCA DE LOS PINES
ESTUDIO DE PROGRAMADORES PONER LEDS: Al final del dc-dc -> poner un jumper donde el LED! Y uno al gpio del micro PONER TEST PONITS: A la entrada de los sensores A la salida de 3.3V A la tierra de GND agujero Poner botón de reset
EN NUCLEO H5RE33 PA5- SCK PA6- MISO PA7- MOSI PA8- CS
BLOQUES: MICRO ALIMENTACIÓN DC-DC 12-5 DC-DC 5-3.3 CIRCUITO 1 AUX ALIM MICRO CIRCUITO 2 AUX VBAT CAN CONECTOR
CONECTOR PROGRAMADOR
clk del debugger
RESISTENCIAS PULL UP (TEMP TYRES I2C)
Calculo R7: (para led rojo o verde) 3.3-2/0.0013 = 100
External node
LDO desactivado
este circuito filtra la alimentación para que la señal de vdda sea mas limpia
PINES: APPS y SUSP conectados a pines analog NRST conectado a pin de reset SWXXX conectados a pines de protocolo SWD
hay un condensador que es del Vddio2! revisar!!
ALIMENTACIÓN
CRYSTAL EXT

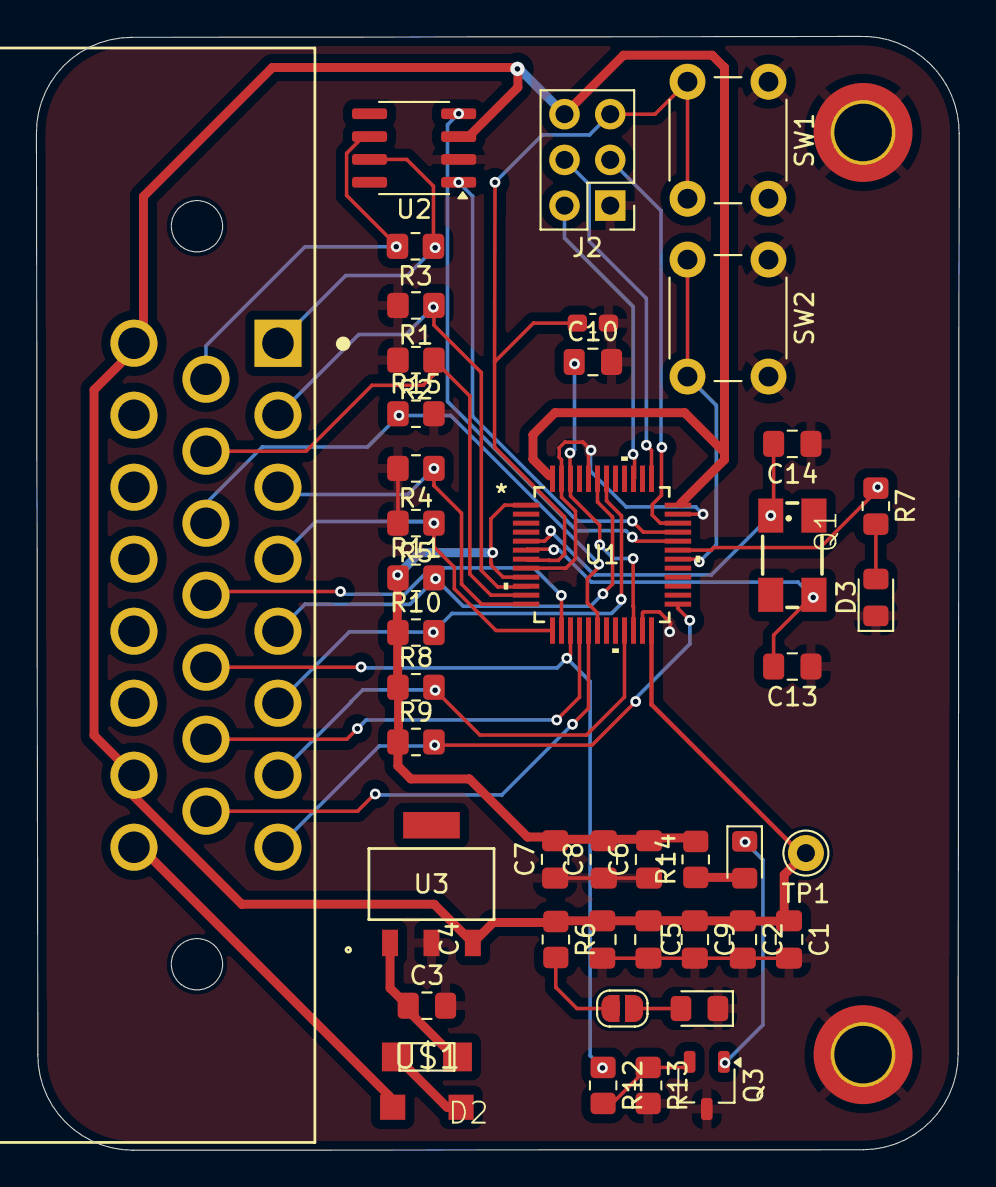
[picture p7: board PCB_TFG_v1.2.kicad_pcb from above]

Board: 2 copper layers, 51.3 x 61.9 mm, 46 parts (0 on the bottom side), 38 nets.
