lorenalam/TFG/Software/NUCLEO_TFG_v2/Core/Src/main.c

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
/* Includes ------------------------------------------------------------------*/
#include "main.h"

/* USER CODE BEGIN PD */

// --- Sensor de presion EPT1400 ---
#define EPT1400_PMAX        100.0f   // bar del modelo
#define EPT1400_VMIN        0.5f     // V a 0 bar (offset del sensor, del datasheet)
#define EPT1400_VSPAN       4.0f     // V de recorrido (4.5 - 0.5, del datasheet)
#define EPT1400_DIVIDER_K   0.6471f  // divisor R1=10k, R2=18.2k -> 4.5V se mapea a 2.91V

// --- Sensor de temperatura de rueda MLX90614 ---
#define MLX90614_ADDR     (0x5A << 1)   // direccion 7-bit desplazada para HAL
#define MLX90614_TOBJ1    0x07          // registro temperatura del objeto

// --- IDs de las tramas CAN ---
#define CAN_ID_APPS     0x100   // acelerador (APPS_1, APPS_2)
#define CAN_ID_SUSP     0x101   // suspension (SUSP_FL, SUSP_FR)
#define CAN_ID_BRAKE    0x102   // presion de freno
#define CAN_ID_TEMPS    0x103   // temperaturas (disco, rueda1, rueda2)

// --- Periodos del scheduler (ms) ---
#define PERIOD_FAST     10      // 100 Hz: APPS, suspension, freno
#define PERIOD_SLOW     250     // 4 Hz: temperaturas

/* USER CODE END PD */


COM_InitTypeDef BspCOMInit;
ADC_HandleTypeDef hadc1;

FDCAN_HandleTypeDef hfdcan1;

I2C_HandleTypeDef hi2c1;
I2C_HandleTypeDef hi2c2;

SPI_HandleTypeDef hspi2;

/* USER CODE BEGIN PV */

//ADC
#define ADC_N_CHANNELS 5
uint16_t adc_val[ADC_N_CHANNELS];
enum { APPS_1 = 0, APPS_2, SUSP_FL, SUSP_FR, BRAKE };

//SPI
float   temp_disco    = 0.0f;   // °C, temperatura disco de freno (MAX6675)
uint8_t max6675_fault = 0;      // 1 = termopar desconectado

//I2C
float temp_tyre1 = 0.0f;   // °C, temperatura rueda 1 (MLX90614 en I2C1)
float temp_tyre2 = 0.0f;   // °C, temperatura rueda 2 (MLX90614 en I2C2)

//CAN
FDCAN_TxHeaderTypeDef TxHeaderApps;
FDCAN_TxHeaderTypeDef TxHeaderSusp;
FDCAN_TxHeaderTypeDef TxHeaderBrake;
FDCAN_TxHeaderTypeDef TxHeaderTemps;

uint32_t t_last_fast = 0;
uint32_t t_last_slow = 0;

/* USER CODE END PV */

void SystemClock_Config(void);
static void MX_GPIO_Init(void);
static void MX_ADC1_Init(void);
static void MX_FDCAN1_Init(void);
static void MX_SPI2_Init(void);
static void MX_I2C1_Init(void);
static void MX_I2C2_Init(void);

/* USER CODE BEGIN PFP */

static void CAN_InitHeader(FDCAN_TxHeaderTypeDef *h, uint32_t id, uint32_t dlc);

/* USER CODE END PFP */

/* USER CODE BEGIN 0 */
static void CAN_InitHeader(FDCAN_TxHeaderTypeDef *h, uint32_t id, uint32_t dlc)
{
    h->Identifier          = id;
    h->IdType              = FDCAN_STANDARD_ID;
    h->TxFrameType         = FDCAN_DATA_FRAME;
    h->DataLength          = dlc;
    h->ErrorStateIndicator = FDCAN_ESI_ACTIVE;
    h->BitRateSwitch       = FDCAN_BRS_ON;
    h->FDFormat            = FDCAN_FD_CAN;
    h->TxEventFifoControl  = FDCAN_NO_TX_EVENTS;
    h->MessageMarker       = 0;
}
/* USER CODE END 0 */

/**
  * @brief  The application entry point.
  * @retval int
  */
int main(void)
{

  /* MCU Configuration--------------------------------------------------------*/

  /* Reset of all peripherals, Initializes the Flash interface and the Systick. */
  HAL_Init();

  /* Configure the system clock */
  SystemClock_Config();

  /* Initialize all configured peripherals */
  MX_GPIO_Init();
  MX_ADC1_Init();
  MX_FDCAN1_Init();
  MX_SPI2_Init();
  MX_I2C1_Init();
  MX_I2C2_Init();
  /* USER CODE BEGIN 2 */

  //ADC CALIBRACIÓN
  if (HAL_ADCEx_Calibration_Start(&hadc1, ADC_SINGLE_ENDED) != HAL_OK)
  {
      Error_Handler();
  }

  // Cabeceras de las 4 tramas
  CAN_InitHeader(&TxHeaderApps,  CAN_ID_APPS,  FDCAN_DLC_BYTES_4);  // 2x uint16
  CAN_InitHeader(&TxHeaderSusp,  CAN_ID_SUSP,  FDCAN_DLC_BYTES_4);  // 2x uint16
  CAN_InitHeader(&TxHeaderBrake, CAN_ID_BRAKE, FDCAN_DLC_BYTES_2);  // 1x uint16
  CAN_InitHeader(&TxHeaderTemps, CAN_ID_TEMPS, FDCAN_DLC_BYTES_8);  // 3x int16 + flags

  /* USER CODE END 2 */

  /* Initialize leds */
  BSP_LED_Init(LED_GREEN);

  /* Initialize USER push-button, will be used to trigger an interrupt each time it's pressed.*/
  BSP_PB_Init(BUTTON_USER, BUTTON_MODE_EXTI);

  /* Initialize COM1 port (115200, 8 bits (7-bit data + 1 stop bit), no parity */
  BspCOMInit.BaudRate   = 115200;
  BspCOMInit.WordLength = COM_WORDLENGTH_8B;
  BspCOMInit.StopBits   = COM_STOPBITS_1;
  BspCOMInit.Parity     = COM_PARITY_NONE;
  BspCOMInit.HwFlowCtl  = COM_HWCONTROL_NONE;
  if (BSP_COM_Init(COM1, &BspCOMInit) != BSP_ERROR_NONE)
  {
    Error_Handler();
  }

  /* Infinite loop */
  /* USER CODE BEGIN WHILE */
  while (1)
  {     uint32_t now = HAL_GetTick();

  // ===== GRUPO RÁPIDO (100 Hz) =====
  if (now - t_last_fast >= PERIOD_FAST)
  {
      t_last_fast = now;

      // --- Lectura ADC (5 canales) ---
      HAL_ADC_Start(&hadc1);
      for (int i = 0; i < ADC_N_CHANNELS; i++)
      {
          if (HAL_ADC_PollForConversion(&hadc1, 10) == HAL_OK)
              adc_val[i] = HAL_ADC_GetValue(&hadc1);
          else
              adc_val[i] = 0xFFFF;
      }
      HAL_ADC_Stop(&hadc1);

      // Presion de freno en bar, escalada x10 -> uint16
      float v_brake_adc = (adc_val[BRAKE] * 3.3f) / 4095.0f;
      float v_brake     = v_brake_adc / EPT1400_DIVIDER_K;
      float p_brake     = (v_brake - EPT1400_VMIN) * EPT1400_PMAX / EPT1400_VSPAN;
      uint16_t brake_x10 = (uint16_t)(p_brake * 10.0f);

      // --- Empaquetado y envio: APPS (raw ADC, big-endian) ---
      uint8_t dApps[4];
      dApps[0] = (uint8_t)(adc_val[APPS_1] >> 8);
      dApps[1] = (uint8_t)(adc_val[APPS_1] & 0xFF);
      dApps[2] = (uint8_t)(adc_val[APPS_2] >> 8);
      dApps[3] = (uint8_t)(adc_val[APPS_2] & 0xFF);
      HAL_FDCAN_AddMessageToTxFifoQ(&hfdcan1, &TxHeaderApps, dApps);

      // --- Suspension (raw ADC) ---
      uint8_t dSusp[4];
      dSusp[0] = (uint8_t)(adc_val[SUSP_FL] >> 8);
      dSusp[1] = (uint8_t)(adc_val[SUSP_FL] & 0xFF);
      dSusp[2] = (uint8_t)(adc_val[SUSP_FR] >> 8);
      dSusp[3] = (uint8_t)(adc_val[SUSP_FR] & 0xFF);
      HAL_FDCAN_AddMessageToTxFifoQ(&hfdcan1, &TxHeaderSusp, dSusp);

      // --- Presion de freno (bar x10) ---
      uint8_t dBrake[2];
      dBrake[0] = (uint8_t)(brake_x10 >> 8);
      dBrake[1] = (uint8_t)(brake_x10 & 0xFF);
      HAL_FDCAN_AddMessageToTxFifoQ(&hfdcan1, &TxHeaderBrake, dBrake);
  }

  // ===== GRUPO LENTO (4 Hz) =====
  if (now - t_last_slow >= PERIOD_SLOW)
  {
      t_last_slow = now;

      // --- Lectura SPI (MAX6675) ---
      uint8_t  spi_rx[2] = {0};
      uint16_t spi_raw   = 0;
      HAL_GPIO_WritePin(SPI2_TEMP_BRK_GPIO_Port, SPI2_TEMP_BRK_Pin, GPIO_PIN_RESET);
      if (HAL_SPI_Receive(&hspi2, spi_rx, 2, 10) == HAL_OK)
      {
          spi_raw = ((uint16_t)spi_rx[0] << 8) | spi_rx[1];
          if (spi_raw & 0x0004)
          {
              max6675_fault = 1;
              temp_disco = -1.0f;
          }
          else
          {
              max6675_fault = 0;
              temp_disco = ((spi_raw >> 3) & 0x0FFF) * 0.25f;
          }
      }
      HAL_GPIO_WritePin(SPI2_TEMP_BRK_GPIO_Port, SPI2_TEMP_BRK_Pin, GPIO_PIN_SET);

      // --- Lectura I2C (2x MLX90614) ---
      uint8_t mlx_buf[2] = {0};
      if (HAL_I2C_Mem_Read(&hi2c1, MLX90614_ADDR, MLX90614_TOBJ1,
                           I2C_MEMADD_SIZE_8BIT, mlx_buf, 2, 10) == HAL_OK)
          temp_tyre1 = (((uint16_t)mlx_buf[1] << 8) | mlx_buf[0]) * 0.02f - 273.15f;

      if (HAL_I2C_Mem_Read(&hi2c2, MLX90614_ADDR, MLX90614_TOBJ1,
                           I2C_MEMADD_SIZE_8BIT, mlx_buf, 2, 10) == HAL_OK)
          temp_tyre2 = (((uint16_t)mlx_buf[1] << 8) | mlx_buf[0]) * 0.02f - 273.15f;

      // --- Empaquetado: temperaturas (int16, °C x10) + flag ---
      int16_t td  = (int16_t)(temp_disco * 10.0f);
      int16_t tt1 = (int16_t)(temp_tyre1 * 10.0f);
      int16_t tt2 = (int16_t)(temp_tyre2 * 10.0f);

      uint8_t dTemps[8];
      dTemps[0] = (uint8_t)(td  >> 8);
      dTemps[1] = (uint8_t)(td  & 0xFF);
      dTemps[2] = (uint8_t)(tt1 >> 8);
      dTemps[3] = (uint8_t)(tt1 & 0xFF);
      dTemps[4] = (uint8_t)(tt2 >> 8);
      dTemps[5] = (uint8_t)(tt2 & 0xFF);
      dTemps[6] = max6675_fault;     // byte de flags
      dTemps[7] = 0;                 // reservado
      HAL_FDCAN_AddMessageToTxFifoQ(&hfdcan1, &TxHeaderTemps, dTemps);

      // --- Debug opcional (descomentar para ver por terminal) ---
      // printf("BRK:%.1f bar | Disco:%.1f Rueda1:%.1f Rueda2:%.1f C (fault=%u)\r\n",
      //        p_brake, temp_disco, temp_tyre1, temp_tyre2, max6675_fault);
  }
      /* USER CODE END WHILE */

    /* USER CODE BEGIN 3 */
  }
  /* USER CODE END 3 */
}

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
