lorenalam/TFG/Software/NUCLEO_TFG_v2/Core/Inc/main.h

#define SPI2_MOSI_TEMP_BRK_Pin GPIO_PIN_1
#define SPI2_MOSI_TEMP_BRK_GPIO_Port GPIOC
#define SPI2_MISO_TEMP_BRK_Pin GPIO_PIN_2
#define SPI2_MISO_TEMP_BRK_GPIO_Port GPIOC
#define APPS_1_Pin GPIO_PIN_0
#define APPS_1_GPIO_Port GPIOA
#define APPS_2_Pin GPIO_PIN_1
#define APPS_2_GPIO_Port GPIOA
#define SUSP_FL_Pin GPIO_PIN_6
#define SUSP_FL_GPIO_Port GPIOA
#define SUSP_FR_Pin GPIO_PIN_4
#define SUSP_FR_GPIO_Port GPIOC
#define PRSS_BRK_Pin GPIO_PIN_1
#define PRSS_BRK_GPIO_Port GPIOB
#define SPI2_SCK_TEMP_BRK_Pin GPIO_PIN_2
#define SPI2_SCK_TEMP_BRK_GPIO_Port GPIOB
#define I2C2_SCL_TEMP_TYRE_2_Pin GPIO_PIN_10
#define I2C2_SCL_TEMP_TYRE_2_GPIO_Port GPIOB
#define I2C2_SDA_TEMP_TYRE_2_Pin GPIO_PIN_12
#define I2C2_SDA_TEMP_TYRE_2_GPIO_Port GPIOB
#define SPI2_TEMP_BRK_Pin GPIO_PIN_8
#define SPI2_TEMP_BRK_GPIO_Port GPIOA
#define SWDIO_Pin GPIO_PIN_13
#define SWDIO_GPIO_Port GPIOA
#define SWCLK_Pin GPIO_PIN_14
#define SWCLK_GPIO_Port GPIOA
#define JTDI_Pin GPIO_PIN_15
#define JTDI_GPIO_Port GPIOA
#define SWO_Pin GPIO_PIN_3
#define SWO_GPIO_Port GPIOB
#define I2C1_SCL_TEMP_TYRE_1_Pin GPIO_PIN_6
#define I2C1_SCL_TEMP_TYRE_1_GPIO_Port GPIOB
#define I2C1_SDA_TEMP_TYRE_1_Pin GPIO_PIN_7
#define I2C1_SDA_TEMP_TYRE_1_GPIO_Port GPIOB
