lorenalam/TFG/(commit log)

2026-01-19 1st upload
    Archivos -prueba canfd -prueba sensores
2026-02-17 v1.2 adc integrado con CANFD
    + prueba aproximada parámetros SPI
2026-04-22 Hardware PCB v1.2
    Versión PCB para posible fabricación
    [PCB_TFG_v1.2.kicad_pcb, PCB_TFG_v1.2.kicad_sch, PCB_TFG_v1.kicad_pcb, PCB_TFG_v1.kicad_sch]
2026-05-07 PCB v1.3
    Cambios:
    Cs de acoplamiento
    Oscilador
    SPI
    Vías alimentación
    Pendiente:
    Vías disipación
    [PCB_TFG_v1.2.kicad_pcb, PCB_TFG_v1.3.kicad_pcb, PCB_TFG_v1.3.kicad_sch]
2026-05-25 AÑADIDO PROYECTO KICAD NUCLEO
    - Se añade el proyecto de KiCAD con el PCB y esquema de la tarjeta núcleo, extraída del proyecto de Altium de los recursos de STM
2026-05-25 CREADA LA CARPETA DE DOCUMENTACIÓN PARA PCB
    - Se añaden los documentos para diseño de PCB de STM
    - Se añaden los documentos para cálculo de Heat Sink
2026-05-25 MODIFICACIONES AL PCB
    - Separación de Áreas Analógica y Digital.
    - Creación de dos planos de GND y Vcc en capas intermedias.
    - Recolocación de los C de desacoplo.
    [PCB_TFG_v1.3.kicad_pcb, PCB_TFG_v1.3.kicad_sch]
2026-05-29 ENRUTADO COMPLETADO
    - Nueva versión del PCB ya enrutado.
    - Modificadas huellas de algunos componentes, principalmente para incluir marca de posición.
    [PCB_TFG_v1.3.kicad_pcb, PCB_TFG_v1.3.kicad_sch]
